damianmoore/hp-server-fan-controller/schematic.pdf

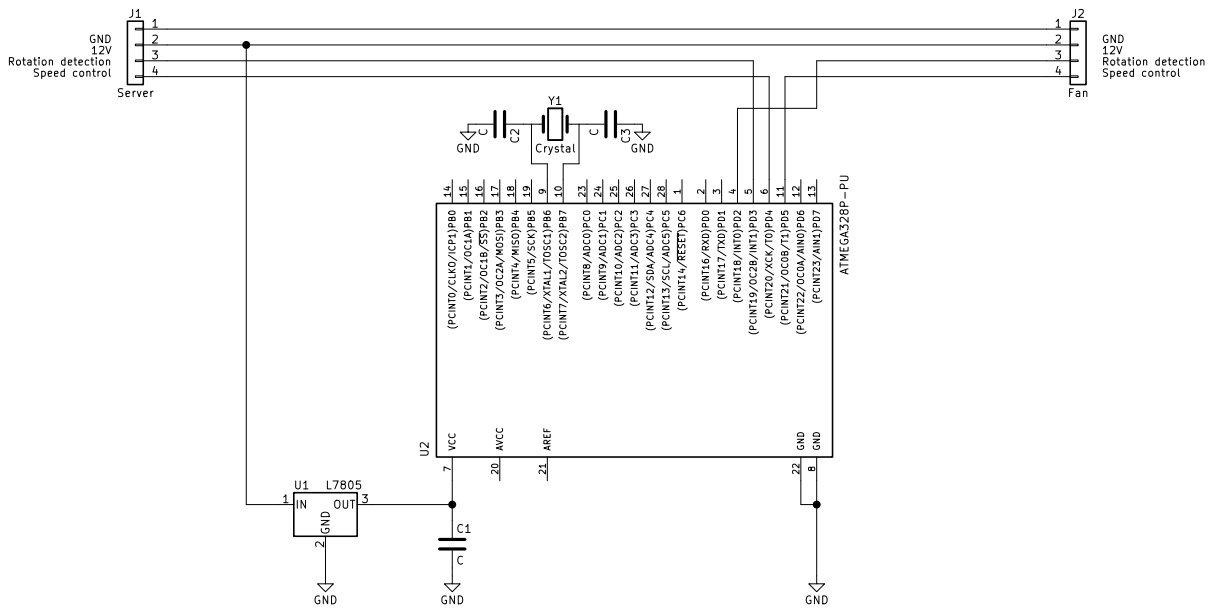
[picture p1: page 1]
