damianmoore/hp-server-fan-controller/hp_server_fan_controller.sch

## KiCad design hp_server_fan_controller.sch (2018-07-31)

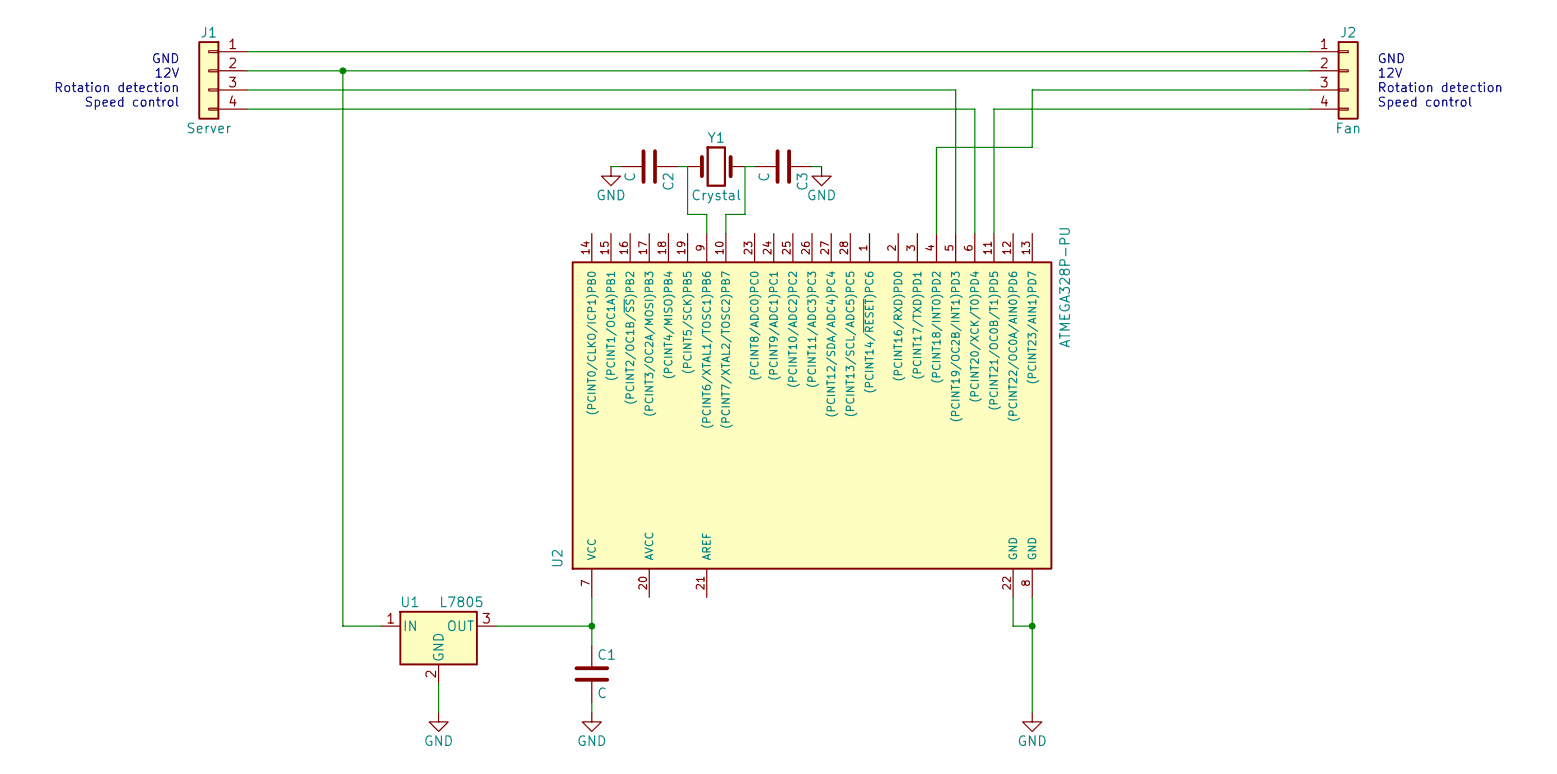
[picture p2: schematic hp_server_fan_controller.sch]

Parts:
C1, C2, C3: C
J1: Server
J2: Fan
U1: L7805
U2: ATMEGA328P-PU; DIL28
Y1: Crystal

Connections:
GND: C1.2, C2.2, C3.1, U1.2 (GND), U2.8 (GND), U2.22 (GND)
unnamed: C1.1, U1.3 (OUT), U2.7 (VCC)
unnamed: C2.1, U2.9 ((PCINT6/XTAL1/TOSC1)PB6), Y1.1
unnamed: C3.2, U2.10 ((PCINT7/XTAL2/TOSC2)PB7), Y1.2
unnamed: J1.1, J2.1
unnamed: J1.2, J2.2, U1.1 (IN)
unnamed: J1.3, U2.5 ((PCINT19/OC2B/INT1)PD3)
unnamed: J1.4, U2.6 ((PCINT20/XCK/T0)PD4)
unnamed: J2.3, U2.4 ((PCINT18/INT0)PD2)
unnamed: J2.4, U2.11 ((PCINT21/OC0B/T1)PD5)

Notes on the sheet:
GND 12V Rotation detection Speed control
