damianmoore/hp-server-fan-controller/(threads)

Thread 1 (2020-11-26):

[Question] Replace PSU fan

k-matti, 2020-11-26:
Hello, I have a question about replacing psu fun.
I bought Sunon HA40201V4-0000-999 but original screws does not fit the holes in Sunon are too big.
How you mounted it properly?

damianmoore, 2020-11-27:
Hmm, this was a while ago but I think the screws fitted OK for me. If you measure the holes to the nearest mm then you should be able to find matching bolts on eBay. If you get bolts that are a bit longer then you could screw nuts on the end also so you don't have to rely on the self-tapping.

k-matti, 2020-11-27:
Thanks :)

Closed 2020-11-27.
